Tlbowman42/F24_Team7_Lochinvar-Fan-Controller/README.md

# Lochinvar Fan Controller
## Executive Summary

The Fan Diagnostic Tool is a compact, modular system designed to test, simulate, and monitor blower fans used in boiler control systems. It streamlines diagnostics by offering multiple modes for real-time monitoring, fan simulation, and signal simulation. By improving testing speed and accuracy, the tool helps reduce development time, and enhance product reliability.

## Capabilities

The current version of our Fan Diagnostic Tool has the following capabilities:

1. Simulate a boiler fan
2. Generate PWM and Tachometer signals that can replicate boiler fans
3. Save user-parameters and load back the lastest saved data.

## Salient Outcomes

As the project progresses these are the outcomes we thought were more impressive than others. Listed below are our salient outcomes for this project:

1. Generate any Lochinvar designated fan signal.
2. Load and save user parameters.
3. Interface both with a function generator and the Lochinvar Control Board.

## Project Demonstration & Images
Photo of the final version of the tool, a video of the tool in Fam Simulation Mode, and a photo of the Lochinvar Control Board.





**Video of the Fan Diagnostic Tool running in Fan Simulation Mode**
https://youtube.com/shorts/UyiWjI823Lc?feature=share

## About Us

### Team

[Layne Bowman](https://www.linkedin.com/in/laynebowman/), an electrical engineering major at Tennessee Technological University, has a strong interest in power systems and renewable energy technologies. Layne oversees the power management systems for the fan diagnostic tool.  

[Ethan Haynes](https://www.linkedin.com/in/ethan-haynes-306a162b0/), an electrical engineering major at Tennessee Technological University, has a strong interest in power systems and renewable energy technologies. Ethan oversees the pre-processing subsystem for the fan diagnostic tool.    

[Jacob Brewer](https://www.linkedin.com/in/jacob-brewer-6b72a1254/) an electrical engineering major at Tennessee Tech University, has an strong interest in power distribution and renewable energy. Jacob oversees the production of the case with Ethan and the post-processing subsystem.  

[Tucker Basham](www.linkedin.com/in/tucker-basham-b77896290) as a computer engineer at Tennessee Tech University, has a strong passion for embedded, control systems, and signal processing. Tucker oversees the signal generation and storage capabilities of the fan diagnostic tool.  

[Conner Vick](https://www.linkedin.com/in/matthew-c-vick/) , an electrical engineering major at Tennessee Technological University, has a strong interest in design. Conner oversees the display for the fan diagnostic tool.  

### Faculty Supervisor

The faculty superviosr for this project is [Dr. JW Bruce](https://www.linkedin.com/in/jw-bruce-0b434326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). He completed his electrical engineering Bachelor's degree from The University of Alabama in Huntsville. He then went on and completed his Masters in electrical engineering at the Georgia Institue of Technology and his PhD in electrical engineering from the University of Nevada-Las Vegas.

### Stakeholders

The primary customer for the project is Lochinvar, which is a apart of the AO-Smith Corporation. There are plans for future capstone teams to develop both the Fan Driving mode and the Signal Passthrough mode.

### Recognitions

We would like to recognize and thank Dr. JW Bruce, Micah Rentschler, and our contacts at Lochinvar for their support and guidance throughout this project.  

## Repo Organization

### [Reports](https://github.com/Tlbowman42/F24_Team7_Lochinvar-Fan-Controller/tree/main/Reports)

The [Project Proposal](https://github.com/Tlbowman42/F24_Team7_Lochinvar-Fan-Controller/blob/main/Reports/Project%20Proposal.md) is the intial document for the project where the problem is defined and the goals for the project.  

The [Conceptual Design](https://github.com/Tlbowman42/F24_Team7_Lochinvar-Fan-Controller/blob/main/Reports/Conceptual%20Design%20and%20Planning.md) gives a more detailed solution to the problem as well as breakdowns the subsystems and gives a projected timeline and budget.  

The [Experimental Analysis](https://github.com/Tlbowman42/F24_Team7_Lochinvar-Fan-Controller/blob/main/Reports/Experimental%20Analysis.md) is where we designed and tested our Fan Diagnostic Tool to see if we met our success criteria set out in the Conceptual Design. 

The [Poster](https://github.com/Tlbowman42/F24_Team7_Lochinvar-Fan-Controller/blob/main/Reports/Capstone_Poster.pdf) is where we showcase our final project to advisors, faculty, and the public.

The [Final Presentation](https://github.com/Tlbowman42/F24_Team7_Lochinvar-Fan-Controller/blob/main/Reports/Final%20Capstone%20Presentation.pptx) is where we showcase our time in Capstone to the Industrial Advisory Board.

### [Documentation](https://github.com/Tlbowman42/F24_Team7_Lochinvar-Fan-Controller/tree/main/Documentation)

All documentation for the project is included in the above folder. Documentation includes all schematics, images, models, BOM, and designs used in the project.

The [Meeting Minutes](https://github.com/Tlbowman42/F24_Team7_Lochinvar-Fan-Controller/tree/main/Documentation/Meeting%20Minutes) folder contains the dated minutes from weekly meetings and allows a quick view into the progress of the team.

### [Software](https://github.com/Tlbowman42/F24_Team7_Lochinvar-Fan-Controller/tree/main/Software)

All software used and created is listed in the [Software](https://github.com/Tlbowman42/F24_Team7_Lochinvar-Fan-Controller/tree/main/Software) directory. For each subsystem, there are specific folders listed to find the necessary code.
