Tlbowman42/F24_Team7_Lochinvar-Fan-Controller/Reports/Jacob - Case & Post-Processing.md

# Function of the Subsystem  
The role of the post-processing subsystem is to step up the incoming Tach and PWM signals coming from the microcontroller. This subsystem will be responsible for electrically isolating the two different voltage levels using light to transfer the signal to the other circuit from the micro controller via an opto-coupler. It also will step up the signals to the necessary 10-12V and 24V DC. Then for the case the function is the protect and enclose the PCB and other components.

# Specifications and Constraints  
*Specifications*  
1. The Post-processing shall step up the tachometer and PWM signal, coming from the microcontroller, to send to the boiler controller.  
2. The Post-processing shall isolate the signal from backfeed.  
3. The case shall encase and protect the board.
4. The case shall have openings for the display, buttons, and ports.
5. The case shall have mounting points to secure the board.
6. The case shall include a raised bezel for the display for protection.  

*Constraints*  
1. The Post-processing must step up the PWM signal up from 3.3V to 24V.
2. The Post-processing must step up the Tach signal up from 3.3V to 10-12V
3. The case must fully protect all components inside of it.  
4. The subsystems must meet IPC J-STD-001.  

*Justifictation for Constraints*  
1. Constraint one applies because it is possible for the amplitude of the signals to be a range of values, but the pwm should be 24V and the tach will be 10V to 12V for accurate measurments.  
2. Constraint two applies because the case is useless if it doesn't provide adequate protection.  
3. Constraint three requires that proper soldering procedures, training, equipment, and materials are used. Following such guidelines will ensure safety and stable connections for the user of the tool and those working on it.

# Overview of Proposed Solution  
The post-processing system starts off with a tachometer and PWM signal (3.3V) that it steps up from the microcontroller to send to the boiler controller 10-12V for the tach signal or 24V for the pwm. It will also have a voltage regulator for the tach signal along with its supporting components. In addition to this, the signal must be isolated to protect the system from power surges. To accomplish this, an opto-coupler circuit will be implemented to meet both of these requirements. This circuit will consist of an opto-coupler, a current limiting resistor, and a pull up resistor. The case will be designed in solidworks then 3D printed.  

# Interfacing with Other Subsystems
Pre-Processing  
-The post-processing and case doesn't have any connection with the pre-processing sub system.  
Memory  
-The post-processing and the case doesn't have any connection with the memory sub system.
Microcontroller   
-The microcontroller subsystem will send a tachometer and PWM signal that has gone through the post-processing circuit.  
Display  
-The Display subsystem will display the interpreted version of the tachometer signal from the microcontroller.  
Case  
-The Case will account for the openings needed for the Molex connector and buttons.  
Power  
-The power system pulls up from the 24 V that went through the polarity checker.  
Display  
-The case will have an opening for the display.  
Ports and Buttons  
-The case will also have openings for all of the buttons and two openings for both of the molex connectors.  

# 3D design for case
Lid  
Screenshot (190)

Inside  
Screenshot (192)

# Buildable Schematic
Screenshot (204)  

Screenshot (205)  

# PCB
Screenshot (206)  

# BOM
| Manufacturer | Manufacturer Part Number | Distributor | Distributor Part Number | Quantity | Cost  | URL  | Lt Spice Name| Device Designations Kicad |
| :---: | :---: | :---: | :---: | :---: | :---: | :---: | :---: | :---: |
| Texas Instruments | LM317HVT/NOPB | Digikey |LM317HVT/NOPB-ND | 1 | $2.44| https://www.digikey.com/en/products/detail/texas-instruments/LM317HVT-NOPB/212662 | U1| U7 |
| KEMET | C333C104F5G5TA | Digikey |C333C104F5G5TA-ND | 1 | $6.10| https://www.digikey.com/en/products/detail/kemet/C333C104F5G5TA/6658919 | C1| C4 |
| Nichicon| UKL2A010KDD | Digikey |493-15407-ND | 1 | $0.43| https://www.digikey.com/en/products/detail/nichicon/UKL2A010KDD/2598552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 | C2| C5 |
| TE Connectivity Passive Product| LR1F240R| Digikey |A121513CT-ND | 1 | $0.10| https://www.digikey.com/en/products/detail/te-connectivity-passive-product/LR1F240R/2381208 | R1| R2d |
| Vishay Beyschlag/Draloric/BC Components | MRS25000C1651FCT00 | Digikey |56-MRS25000C1651FCT00CT-ND | 1 | $0.38| https://www.digikey.com/en/products/detail/vishay-beyschlag-draloric-bc-components/MRS25000C1651FCT00/5064119| R2| R21 |
| Vishay Dale | CMF5530R000FHEB | Digikey |541-CMF5530R000FHEBTR-ND | 1 | $0.80|https://www.digikey.com/en/products/detail/vishay-dale/CMF5530R000FHEB/3618953 | X | R22 |
| Stackpole Electronics Inc | RSMF1JT2K00 | Digikey |RSMF1JT2K00TR-ND | 2 | $0.40| https://www.digikey.com/en/products/detail/stackpole-electronics-inc/RSMF1JT2K00/1694491 | R3 and R4| R14 and R15 |
| Sharp Microelectronics | PC817X1YSZW | Mouser |852-PC817X1YSZW | 2 | $1.28| https://www.mouser.com/ProductDetail/Sharp-Microelectronics/PC817X1YSZW?qs=t7xnP681wgVcLhY5Ec%252BPYQ%3D%3D | U3 and U4| U5 and U6 |
| YAGEO | MFR-25FRF52-210R | Digikey |13-MFR-25FRF52-210RTR-ND | 2 | $0.20|https://www.digikey.com/en/products/detail/yageo/MFR-25FRF52-210R/14826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 | R1 and R2| R16 and R17 |
| ANYCUBIC | PLA filament | Amazon |PLA filament| 2 | $11.99|https://www.amazon.com/ANYCUBIC-Printer-Filament-Dimensional-Accuracy/dp/B0834W2MQN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 | Case| Case |
| Total | | | | | $ 24.12|  |  |

# Analysis
This document presents an analysis of the post-processing and case subsystem. The post-processing section is designed to receive PWM and TACH signals as inputs from the microcontroller. These signals are then stepped up to the appropriate voltage levels. Specifically, the PWM signal is increased from 3.3V to 24V, while the TACH signal is elevated from 3.3V to a range of 10-12V. The PWM circuit outputs a current of 10mA, and the TACH circuit outputs 5mA.  

The circuit begins with the PWM and TACH signal currents flowing through a 210 Ohm resistor. This configuration ensures that the forward current passing through the opto-coupler's LED remains within the desired range, thereby enhancing the longevity of the component and providing an accurate signal for processing. The selected opto-coupler, a PC817A, is well-suited for the 6 kHz PWM signal that needs to be processed. It can handle a maximum voltage of up to 40 Vdc, as specified in the datasheet, and has a cutoff frequency of 80 kHz with rise and fall times of up to 18 µs. These specifications allow the component to process the 6 kHz frequency signal without introducing significant distortion or delay. The 210 Ohm resistor value was determined using the formula ((V1-Vf)/i), calculated as ((3.3V - 1.2V)/10ma). On the output side of the opto-coupler for the PWM signal, a 2k Ohm resistor is employed. This resistor was originally 1.2k Ohms, but testing revealed that a 2k Ohm resistor produced a better output signal.  

The TACH signal required a more complex approach because it needed to be stepped up specifically to 10V, as requested by Lochinvar. Similar to the PWM signal, a 2k Ohm step-up resistor was used to improve the signal quality. However, in this case, a 10V to 40V linear converter was added to achieve the desired TACH output range of 10-12V.  

Tach
Screenshot (207)  

PWM
Screenshot (202)  

These picture shows the PWM and TACH out signals. The PWM shows the 24V output and the TACH shows the how the linear converter needs about 15ms to hit peak output voltage. Then the current going to the opto-coupler will be the same for both. Also you can see in the TACH ouput that it ramps up over time due to the linear converter.

PWM
Screenshot (199)

Screenshot (196)  

TACH
Screenshot (208)  
Screenshot (209)  

Then for the case it is pretty simple. The box/internal design shows the two holes needed for the controller and fan molex connectors. As well I rounded the corners on the inside of the case to allow room to be able screw the lid to the top of the box. Then the 4 pegs is where the flyback converter will be mounted and secured. Finally for the lid of the case we just have an opening for the LCD display and holes for all of the buttons. Although the case is subject to change due to the PCB layout being updated and improved through Bruce's guidance.

# References
[1] IEC 61010-2-081 - safety requirements for electrical equipment for measurement, control, and laboratory use – part 2-081: Particular requirements for automatic and semi-automatic laboratory equipment for analysis and other purposes | Engineering360,” GlobalSpec, https://standards.globalspec.com/std/13207536/IEC%2061010-2-081 (accessed Nov 22, 2024).

[2] "PC817X1YSZW" Sharp Electronics, https://www.mouser.com/datasheet/2/365/Sharpelectronics_08292023_73758-3310502.pdf (accessed Nov. 22, 2024).

[3] "https://www.digikey.com/en/products/detail/analog-devices-inc/LTC3115EDHD-1-PBF/3074265"

[4] "https://www.analog.com/media/en/technical-documentation/data-sheets/LTC3115-1.pdf"
