Tlbowman42/F24_Team7_Lochinvar-Fan-Controller/Questions for Abbey.md

Place any questions you will have for Abbey here.
1. Can you provide anymore information for the signals for our device, such as PWM input, tachometer output, and could you provide examples of the PWM and tachometer signals?
2. On the provided block diagram what does Circuitry / Isolation mean? In what way is the circuitry isolated?
3. In the fan driving mode, what voltage does the blower run off of? (Single-Phase 120 V?)
4. For the monitoring mode how many data points do our graphs need to be comprised of? (This will determine how complex our microcontroller needs to be for the software pass through mode.)

Come up with some crazy senarios, all of the ways it can go wrong and then go back to Abbey to get some more information. (These are big pictures then go into the more detail stuff) Throw the block diagram on the screen and just come up with what if scenario.  

Write a list of requirements that the tool needs to be and send it over to Abbey. Requirements are the big picture and using the basic knowledge and turning that basic knowledge into techincal details.  

Go back to Bruce and see if he will loosen his requirements for a working prototype.
