Tlbowman42/F24_Team7_Lochinvar-Fan-Controller/Documentation/Meeting Minutes/Minutes - 2025-03-26.md

# Wednesday, March 26th, 2025

## Attendance
**In Person** on 03/26/2025
1. Ethan Haynes
2. Layne Bowman
3. Tucker Basham
4. Jacob Brewer
5. Conner Vick

## Key Points
1. Worked on Experimental Analysis

2. Overall bug fixing

## Action Items for Past Meeting
1. We started Experimental Analysis and are closed to having a version to be peer reviewed.  

## Member Updates

Tucker Basham finished with testing the signal inputting and tach generation.  
Ethan Haynes found new 6 pin opto-couplers and helped test subsystems.  
Jacob Brewer picked up new board and button models.  
Conner Vick fixed bugs with LCD and was present for Experimental Analysis testing.  
Layne Bowman finished the Experimental Analysis testing both the power and memory subsystems.   

## Meeting Minutes
We started Experimental Analysis. We finished up most of our testing and need to document everything and submit it for peer review. We also found a new issue with the board that we are unsure of the causation. We are unsure on if it is a power or grounding issue, and we have tested multiple potential solutions with only one fixing the issue. We plan to look into that issue further this week and determine if it is a design issue or if we have damaged something.  

## Action Items for Next Meeting
To do list for the team:  
1. Turn in Experimental Analysis.

2. Work on PCB design and determine if another board would be possible to fix the issues we have come across.  

Ethan Haynes will work on a new board revision with Layne and continue testing with the board.  
Layne Bowman will look into issue on the board. Unsure if it is a power issue or a grounding issue.  
Tucker Basham will continue to work on the fan simulation mode and get better interface with the Lochinvar control board.  
Jacob Brewer will continue to work on the buttons. Then will help where needed.  
Conner Vick will help where needed.
