Tlbowman42/F24_Team7_Lochinvar-Fan-Controller/Documentation/Meeting Minutes/Minutes - 2024-10-23.md

# Wednesday, October 23th, 2024

## Attendance
**In Person:** on 10/23/2024
1. Ethan Haynes
2. Jacob Brewer
3. Conner Vick
4. Layne Bowman
5. Tucker Basham

**In Person** on 10/24/2024
1. Ethan Haynes
2. Jacob Brewer
3. Conner Vick
4. Layne Bowman
5. Tucker Basham

## Key Points
1. Explaining what we learned from our Lochinvar monthly meeting.

2. We went over what components we are looking at for each subsystem.
   
## Action Items for Past Meeting
1. We turned in our conceptual design for review.
  
2. We came up with outlier cases.

## Member Updates
Tucker Basham has found a possible microchip for the tool and has begun looking into code.  
Ethan Haynes has been learning KiCad and PCB design.  
Jacob Brewer looked into using solidworks software for the design of the case.  
Conner Vick has looked into the specifics behind selecting a display.  
Layne Bowman looked into different power ICs and also figured out how to do circuit analysis in Kicad, and designed a basic PCB.  

## Meeting Minutes
The team met with Lochinvar and they answered our questions. They also are going to send us some blower fans and the old fan diagnostic tool. We additionally explained the meeting to Dr Bruce and what new items we learned. Some examples of that information would be we do not have to provide the 120 V single phase power to drive the fan, the electrical isolation is specfically using opto-isolator, and we do not need to have graphs on our user interface. We also as a team explained the specific components we are planning on using.  

Tucker Basham has found a possible microchip for the tool and has begun looking into code.  
Ethan Haynes has been learning KiCad and PCB design.  
Jacob Brewer looked into using solidworks software for the design of the case.  
Conner Vick has looked into the specifics behind selecting a display.  
Layne Bowman looked into different power ICs and also figured out how to do circuit analysis in Kicad, and designed a basic PCB.  

## Action Items for Next Meeting
To do list for the team:  
1. Storyboard the design.
2. Finishing up selecting components for our design.

Ethan Haynes will watch KiCad tutorials.  
Layne Bowman will look into opto-isolators to isolate our power circuit from the microcontroller.  
Tucker Basham will look into procuring an STM32L452 chip or Nucleo-L452 board.  
Jacob Brewer look into how to download solidworks for free.  
Conner Vick will get menu design more finalized for team review.
