Tlbowman42/F24_Team7_Lochinvar-Fan-Controller/Gantt Chart.pdf

Team 7 | Legend:
Project start date: | 8/29/2024 | September | October
Scrolling increment: | 14 | 12 13 14 15 16 17 18 | 19 20 21 22 23 24 25 | 26 27 28 29 30 | 1 | 2 | 3 | 4 | 5 | 6 | 7 | 8 | 9 | 10 11 12 13 14 15 | 16 | 17 18 19 20 21 22 23 | 24 25 26 27 28 29 30 | 31 | 1 | 2 | 3 | 4 | 5 | 6 | 7 | 8 | 9 | 10 | 11 | 12 | 13 | 14 | 15 | 16
Milestone description | Category | Progress | Start | Days | T | F | S | S | M | T | W | T | F | S | S | M | T | W | T | F | S | S | M | T | W | T | F | S | S | M | T | W | T | F | S | S | M | T | W | T | F | S | S | M | T | W | T | F | S | S | M | T | W | T | F | S | S | M | T | W | T | F | S | S | M | T | W | T | F | S
Project Proposal | On Track | 9/12/2024 | 18
Preliminary Research | Low Risk | 9/25/2024 | 14
Conceptual Design Drafting | On Track | 10/9/2024 | 8
Fall Break | On Track | 10/17/2024 | 2
Conceptual Design Finalize | Low Risk | 10/18/2024 | 10
Subsystem Interfacing | Med Risk | 10/21/2024 | 14
Circuit Design | High Risk | 10/21/2024 | 21
PCB Design | 11/10/2024 | 21
Detailed Design | On Track | 10/28/2024 | 34
Final Presentation | Low Risk | 11/17/2024 | 14
Winter Break | On Track | 12/12/2024 | 35
Ordering | On Track | 1/16/2025 | 14
PCB Assembly | Low Risk | 1/26/2025 | 24

## Programming Microcontrollers

| On Track | 1/26/2025 | 30
Experimentation & analysis | Low Risk | 2/1/2025 | 28
Iteration and debug | On Track | 3/1/2025 | 60

## Final report and presentation

Low Risk | 4/1/2025 | 30

To add more data, Insert new rows ABOVE this one

High risk | Unassigned

# PROJECT: Lochinvar Fan Diagonostic Tool

On track | Low risk | Med risk

December | January | February
17 | 18 | 19 | 20 | 21 | 22 | 23 | 24 25 26 27 28 29 | 30 | 1 | 2 | 3 | 4 | 5 | 6 | 7 | 8 | 9 | 10 | 11 | 12 | 13 | 14 | 15 16 17 18 19 20 | 21 | 22 | 23 | 24 | 25 | 26 | 27 | 28 | 29 | 30 | 31 | 1 | 2 | 3 | 4 | 5 | 6 | 7 | 8 | 9 | 10 11 12 | 13 | 14 | 15 | 16 | 17 | 18 | 19 | 20 | 21 | 22 | 23 | 24 | 25 | 26 | 27 | 28 29 30 31 | 1 | 2 | 3 | 4 | 5 | 6 | 7 | 8 | 9 | 10 | 11 | 12 | 13 | 14 | 15
S | M | T | W | T | F | S | S | M | T | W | T | F | S | S | M | T | W | T | F | S | S | M | T | W | T | F | S | S | M | T | W | T | F | S | S | M | T | W | T | F | S | S | M | T | W | T | F | S | S | M | T | W | T | F | S | S | M | T | W | T | F | S | S | M | T | W | T | F | S | S | M | T | W | T | F | S | S | M | T | W | T | F | S | S | M | T | W | T | F | S

March | April | May
16 | 17 | 18 | 19 | 20 21 22 23 24 25 | 26 | 27 | 28 | 1 | 2 | 3 | 4 | 5 | 6 | 7 | 8 | 9 | 10 | 11 | 12 | 13 | 14 | 15 | 16 | 17 | 18 | 19 | 20 | 21 | 22 | 23 | 24 | 25 | 26 | 27 | 28 29 30 31 | 1 | 2 | 3 | 4 | 5 | 6 | 7 | 8 | 9 | 10 | 11 | 12 | 13 | 14 | 15 | 16 | 17 | 18 19 20 21 22 23 | 24 | 25 | 26 27 28 29 30 | 1 | 2 | 3 | 4 | 5 | 6 | 7 | 8 | 9 | 10 | 11 | 12 | 13 | 14 | 15 | 16 | 17
S | M | T | W | T | F | S | S | M | T | W | T | F | S | S | M | T | W | T | F | S | S | M | T | W | T | F | S | S | M | T | W | T | F | S | S | M | T | W | T | F | S | S | M | T | W | T | F | S | S | M | T | W | T | F | S | S | M | T | W | T | F | S | S | M | T | W | T | F | S | S | M | T | W | T | F | S | S | M | T | W | T | F | S | S | M | T | W | T | F | S

18 | 19 20 21 22 23 24 | 25 | 26 | 27 | 28 | 29 | 30 | 31 | 1 | 2
S | M | T | W | T | F | S | S | M | T | W | T | F | S | S | M
