Tlbowman42/F24_Team7_Lochinvar-Fan-Controller/Documentation/Meeting Minutes/Minutes - 2024-10-02.md

# Wednesday, October 2th, 2024

## Attendance
**In Person:** on 10/02/2024
1. Tucker Basham
2. Ethan Haynes
3. Jacob Brewer
4. Conner Vick
5. Layne Bowman

## Key Points
1. Getting Dr. Bruce's Github username, and sending him a review to approve of the project proposal.  

2. Created a draft block diagram to break up our problem into smaller subsections.  

3. Gave specific sections of the conceptual design to the team members.  

4. Assigned customers to each subsection.  

## Action Items for Past Meeting
1. Tucker sent Lochinvar our questions and we had a few of them answered.

2. Micah has approved the project proposal.

## Member Updates
Ethan Haynes finished the goals, Gantt Chart, and the goals for the project proposal.  
Tucker Basham finished the relevant literature for the project proposal.  
Layne Bowman finished the specifications and constraints and the goals for the project proposal.  
Jacob Brewer finished the broader impacts for the project proposal.  
Conner Vick finished the introduction section for the project proposal.  

## Meeting Minutes
The team met with Bruce and recapped the previous week with him. We also had him look over our project proposal, and we are in the process of sending him a pull request for him to digitally sign it. The team also broke down our project into subsections. The following subsections for each group member is displayed below.  

Tucker Basham has been assigned the back-end software design subsection.  
Ethan Haynes has been assigned the physical design subsection.  
Jacob Brewer has been assigned the circuitry subsection.  
Conner Vick has been assigned the front-end software design subsection.  
Layne Bowman has been assigned the power management subsection.  

The customers assignments are shown belowed:  

Tucker Basham is the customer for the circuitry subsection.  
Ethan Haynes is the customer for the power management subsection.  
Jacob Brewer is the customer for the front-end design subsection.  
Conner Vick is the customer for the back-end design subsection.  
Layne Bowman is the customer for the physical design subsection.  

The manager role will be assumed by the whole team instead of having individual managers.  

## Action Items for Next Meeting
To do list for the team:  
1. Then specify who will be doing the detailed design for that subsection.
2. Send Dr. Bruce the pull request for him to sign off on.
3. To come up with some crazy senarios for things to go wrong for our tool. The purpose of this is to find outliers, so we can base questions off on and get clarity from Abbey Ward.  

Tucker Basham: Will come up with specifications for the circuitry subsection.  
Ethan Haynes: Will come up with specifications for the power management subsection.  
Layne Bowman: Will come up with specifications for the physical design subsection.  
Jacob Brewer: Will come up with specifications for the front-end design subsection.  
Conner Vick: Will come up with specifications for the back-end design subsection.
