Tlbowman42/F24_Team7_Lochinvar-Fan-Controller/Documentation/Meeting Minutes/Lochinvar Meeting Minutes 10-23-2024.pdf

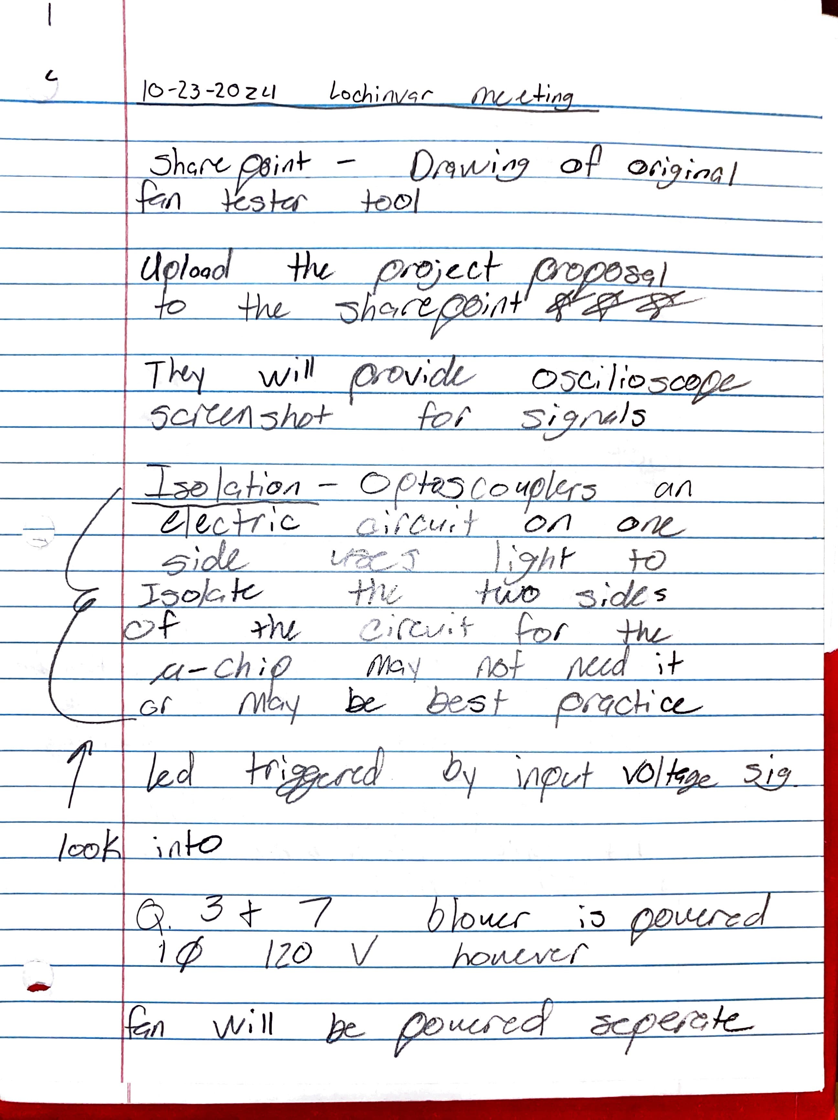
[picture p3: page 1]
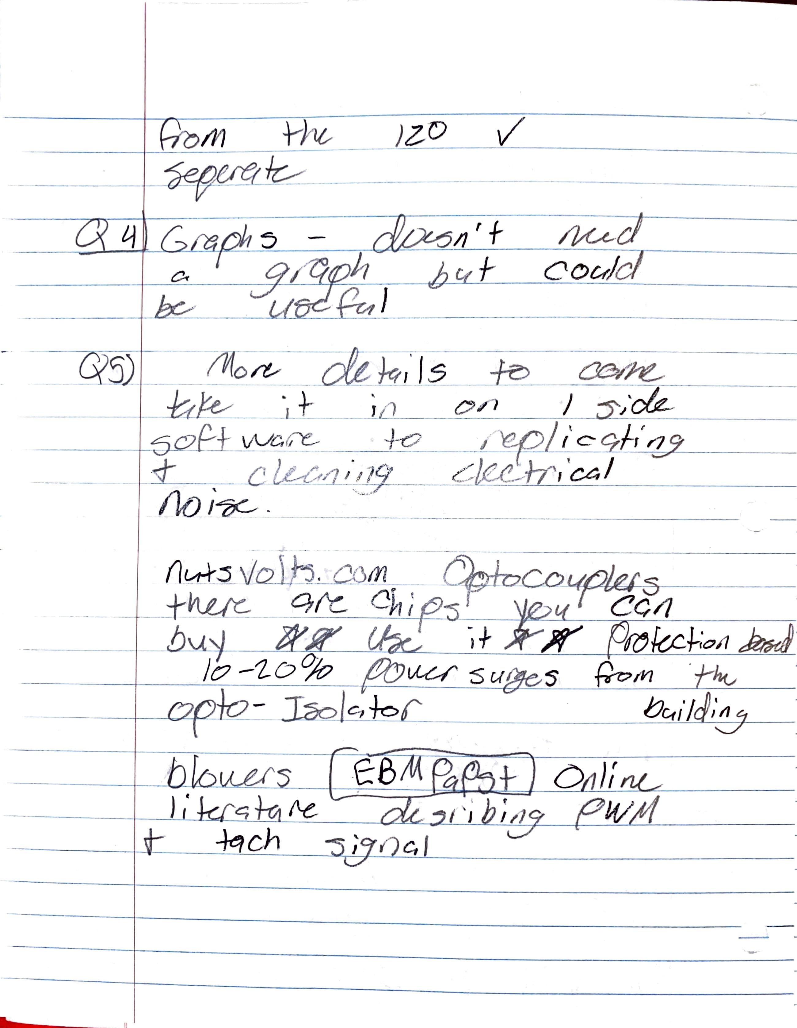
[picture p4: page 2]
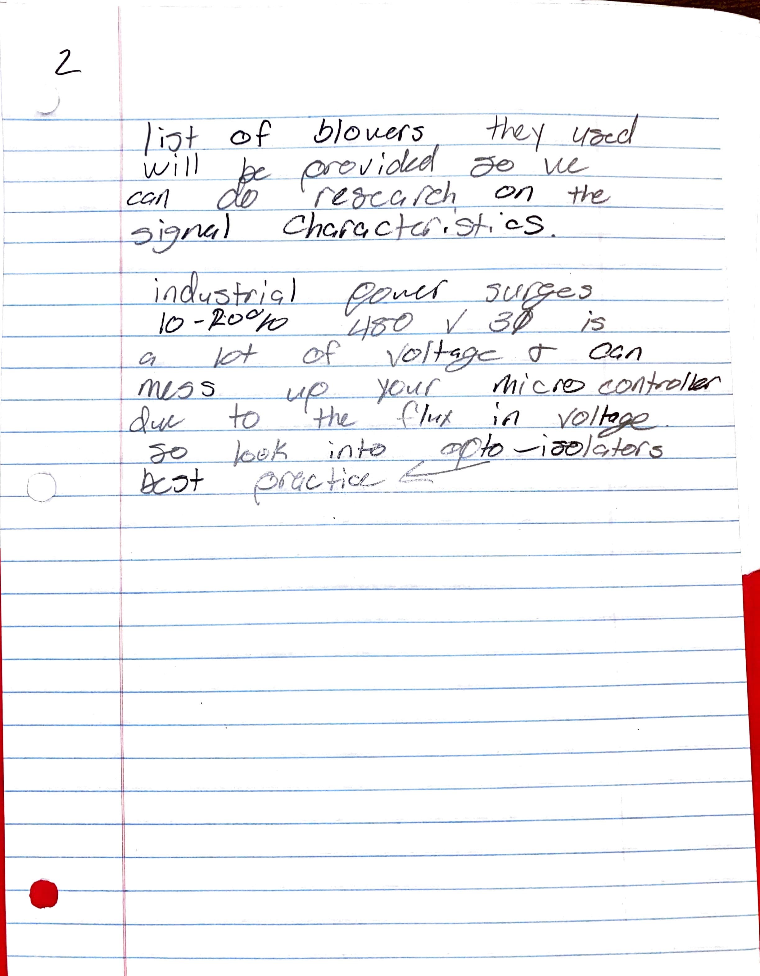
[picture p5: page 3]
