Tlbowman42/F24_Team7_Lochinvar-Fan-Controller/(list of files, cad)

Other CAD files:
Reports/Poster Template/Images/INN_Topology.dwg
