Tlbowman42/F24_Team7_Lochinvar-Fan-Controller/Testing.kicad_sch

## KiCad design Testing.kicad_sch (2025-01-27)

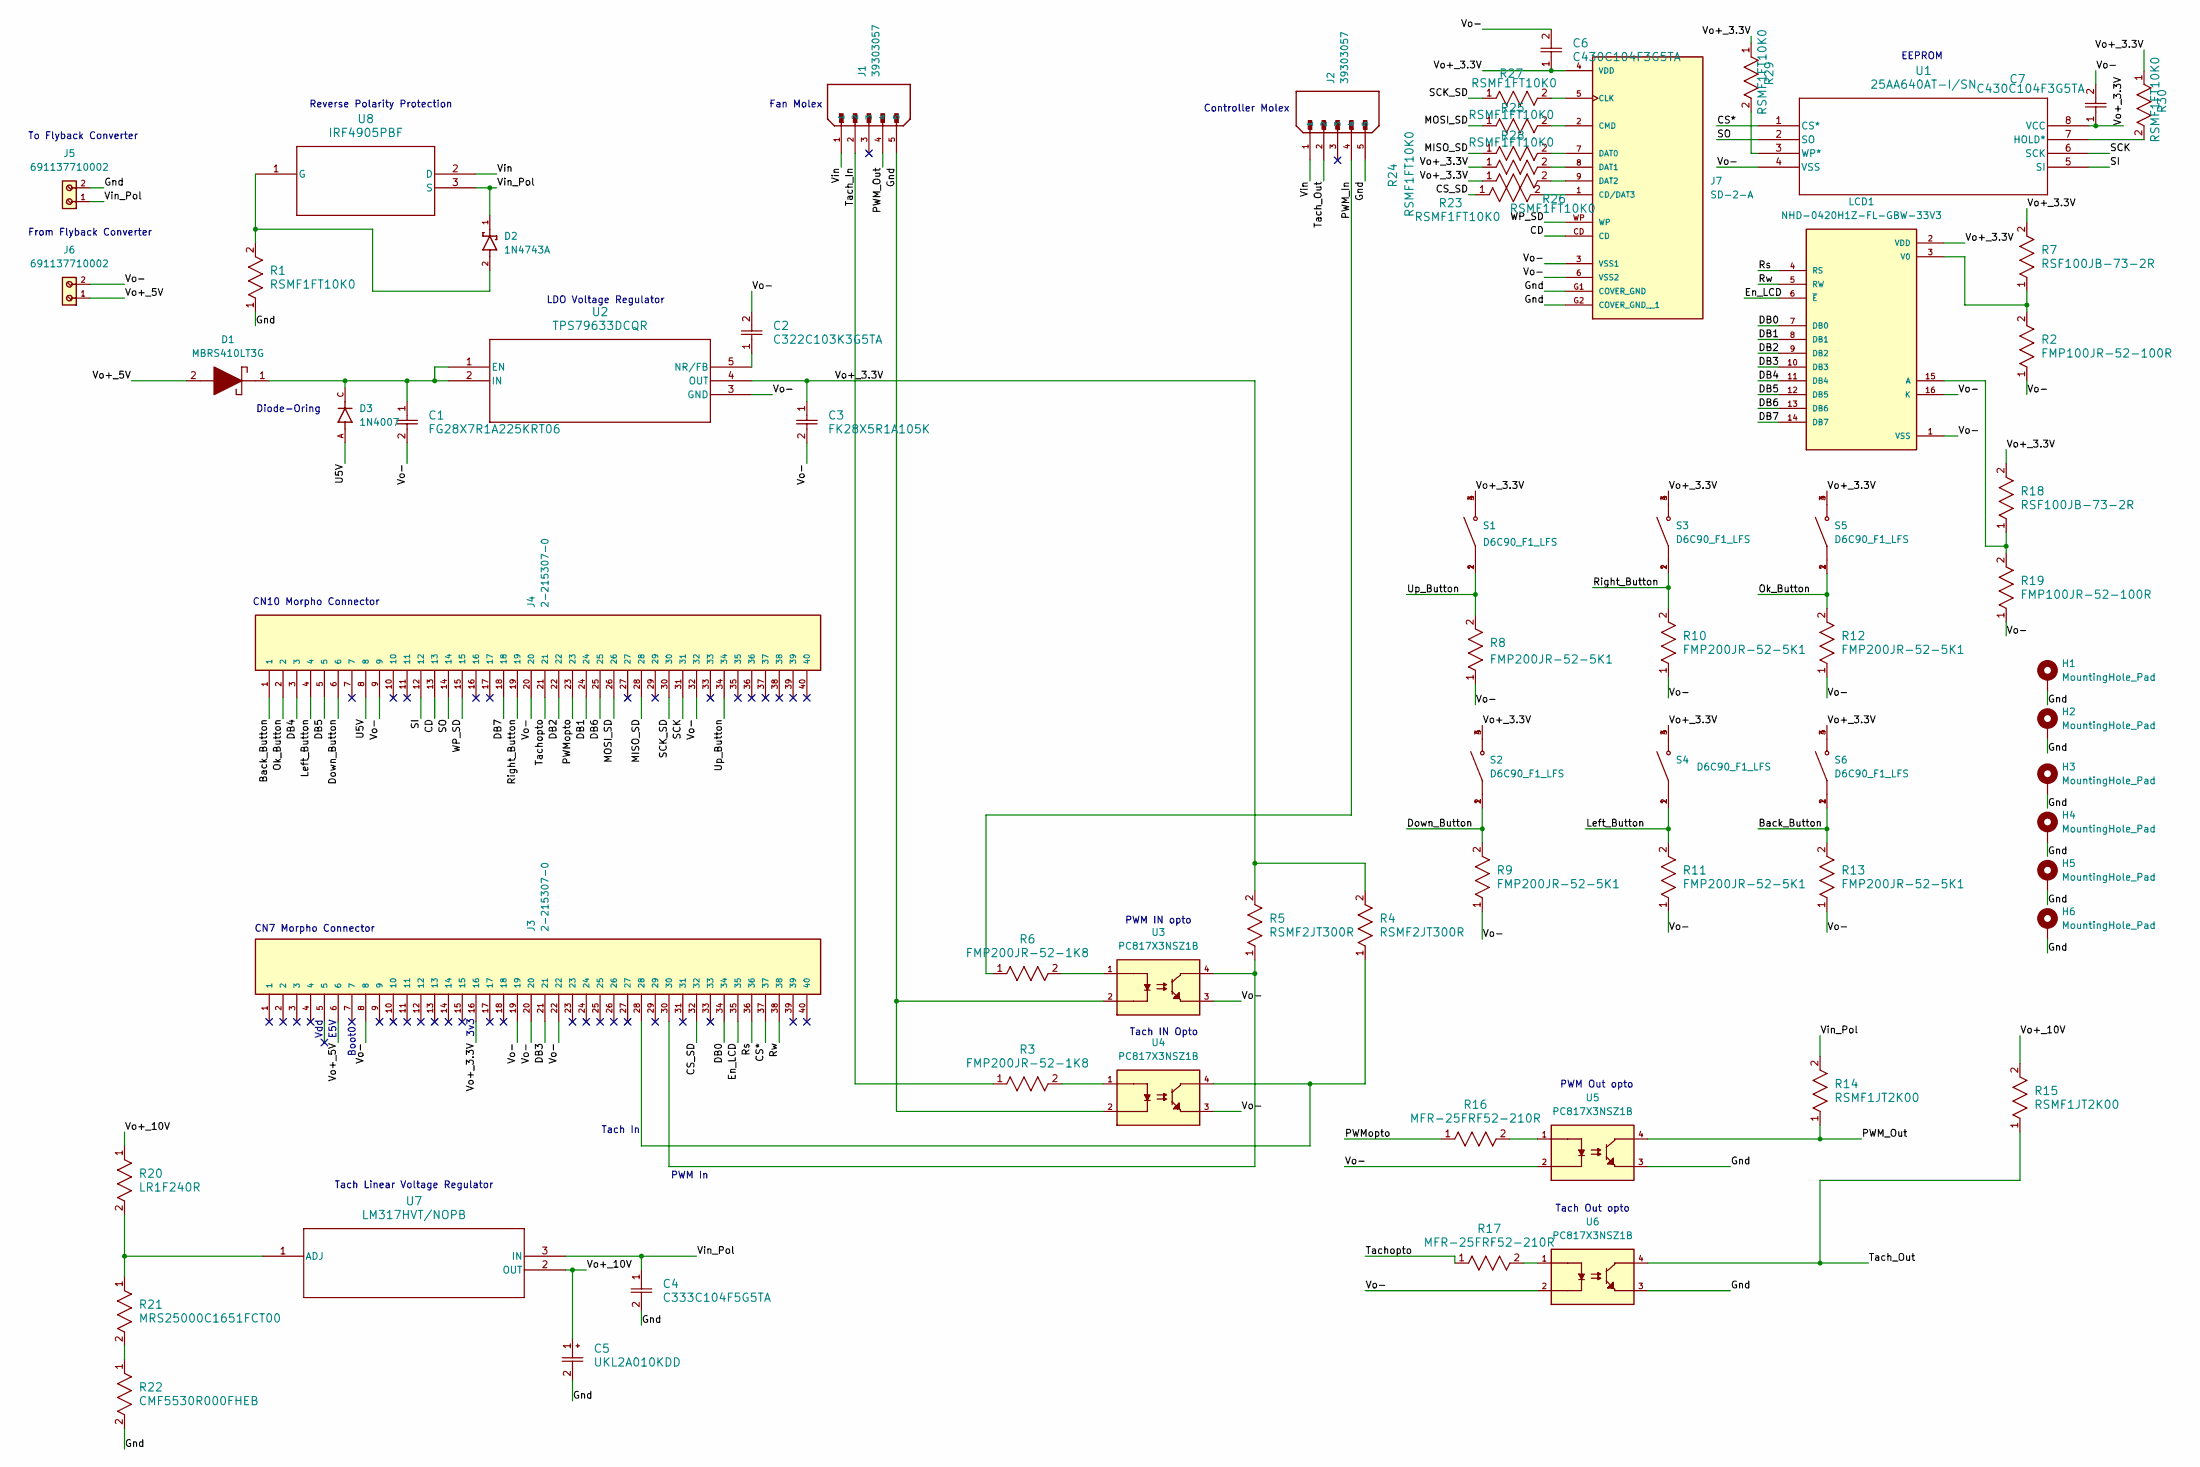
[picture p9: schematic Testing.kicad_sch]

Parts:
C1: FG28X7R1A225KRT06
C2: C322C103K3G5TA
C3: FK28X5R1A105K
C4: C333C104F5G5TA
C5: UKL2A010KDD
C6, C7: C430C104F3G5TA
D1: MBRS410LT3G; DIOM8059X261N; Manufacturer_Part_Number MBRS410LT3G; Mouser Part Number 863-MBRS410LT3G
D2: 1N4743A; DIOAD1036W78L463D272; PARTREV 10
D3: 1N4007; DIOAD1060W80L520D270; PARTREV G
H1, H2, H3, H4, H5, H6: MountingHole_Pad; MountingHole_5.3mm_M5_ISO7380_Pad_TopBottom
J1, J2: 39303057; MOLEX_39303057; PARTREV A
J3, J4: 2-215307-0; TE_2-215307-0; PARTREV R
J5, J6: 691137710002; PART-NUMBER 691137710002
J7: SD-2-A; SD_2_A; PARTREV 1.0
LCD1: NHD-0420H1Z-FL-GBW-33V3; LCD_NHD-0420H1Z-FL-GBW-33V3; PARTREV 02
R1: RSMF1FT10K0; FMP200JR_52_1K8
R2, R19: FMP100JR-52-100R; FMP100JR_52_100R
R3, R6: FMP200JR-52-1K8; FMP200JR_52_1K8
R4, R5: RSMF2JT300R; FMP200JR_52_1K8
R7, R18: RSF100JB-73-2R; RSF100JB_73_2R
R8, R9, R10, R11, R12, R13: FMP200JR-52-5K1; FMP200JR_52_5K1
R14, R15: RSMF1JT2K00; FMP100JR_52_100R
R16, R17: MFR-25FRF52-210R; MFR_25FRF52_210R
R20: LR1F240R
R21: MRS25000C1651FCT00
R22: CMF5530R000FHEB
R23, R24, R25, R26, R27, R28, R29, R30: RSMF1FT10K0; FMP100JR_52_1K2
S1, S2, S3, S4, S5, S6: D6C90_F1_LFS; SW_D6C90_F1_LFS; PARTREV 21 Feb 22
U1: 25AA640AT-I/SN; 25AA640AT_I_SN
U2: TPS79633DCQR
U3, U4, U5, U6: PC817X3NSZ1B; DIP762W50P254L495H455Q4; PARTREV October 7, 2016
U7: LM317HVT/NOPB; LM317HVT_NOPB
U8: IRF4905PBF

Connections:
Back_Button: J4.1, R13.2, S6.1, S6.2
CD: J4.13, J7.CD
CS*: J3.37, U1.1 (CS*)
CS_SD: J3.32, R26.1
DB0: J3.34, LCD1.7 (DB0)
DB1: J4.24, LCD1.8 (DB1)
DB2: J4.22, LCD1.9 (DB2)
DB3: J3.21, LCD1.10 (DB3)
DB4: J4.3, LCD1.11 (DB4)
DB5: J4.5, LCD1.12 (DB5)
DB6: J4.25, LCD1.13 (DB6)
DB7: J4.18, LCD1.14 (DB7)
Down_Button: J4.6, R9.2, S2.1, S2.2
En_LCD: J3.35, LCD1.6 (~E)
Gnd: C4.2, C5.2, H1.1, H2.1, H3.1, H4.1, H5.1, H6.1, J1.5, J2.5, J5.2, J7.G1 (COVER_GND), J7.G2 (COVER_GND__1), R1.1, R22.2, U3.2, U4.2, U5.3, U6.3
Left_Button: J4.4, R11.2, S4.1, S4.2
MISO_SD: J4.28, R28.1
MOSI_SD: J4.26, R25.1
unnamed: C1.1, D1.1, D3.C, U2.1 (EN), U2.2 (IN)
unnamed: C2.1, U2.5 (NR/FB)
unnamed: D2.2, R1.2, U8.1 (G)
unnamed: J3.28, R4.1, U4.4
unnamed: J3.30, R5.1, U3.4
unnamed: J7.1 (CD/DAT3), R26.2
unnamed: J7.2 (CMD), R25.2
unnamed: J7.5 (CLK), R27.2
unnamed: J7.7 (DAT0), R28.2
unnamed: J7.8 (DAT1), R23.2
unnamed: J7.9 (DAT2), R24.2
unnamed: LCD1.3 (V0), R2.2, R7.1
unnamed: LCD1.15 (A), R18.1, R19.2
unnamed: R3.2, U4.1
unnamed: R6.2, U3.1
unnamed: R16.2, U5.1
unnamed: R17.2, U6.1
unnamed: R20.2, R21.1, U7.1 (ADJ)
unnamed: R21.2, R22.1
unnamed: R29.2, U1.3 (WP*)
unnamed: R30.2, U1.7 (HOLD*)
Ok_Button: J4.2, R12.2, S5.1, S5.2
PWM_In: J2.4, R6.1
PWM_Out: J1.4, R14.1, U5.4
PWMopto: J4.23, R16.1
Right_Button: J4.19, R10.2, S3.1, S3.2
Rs: J3.36, LCD1.4 (RS)
Rw: J3.38, LCD1.5 (RW)
SCK: J4.31, U1.6 (SCK)
SCK_SD: J4.30, R27.1
SI: J4.12, U1.5 (SI)
SO: J4.14, U1.2 (SO)
Tach_In: J1.2, R3.1
Tach_Out: J2.2, R15.1, U6.4
Tachopto: J4.21, R17.1
U5V: D3.A, J4.8
Up_Button: J4.34, R8.2, S1.1, S1.2
Vin: J1.1, J2.1, U8.2 (D)
Vin_Pol: C4.1, D2.1, J5.1, R14.2, U7.3 (IN), U8.3 (S)
Vo+_3.3V: C3.1, C6.1, C7.1, J3.16, J7.4 (VDD), LCD1.2 (VDD), R4.2, R5.2, R7.2, R18.2, R23.1, R24.1, R29.1, R30.1, S1.3, S1.4, S2.3, S2.4, S3.3, S3.4, S4.3, S4.4, S5.3, S5.4, S6.3, S6.4, U1.8 (VCC), U2.4 (OUT)
Vo+_5V: D1.2, J3.6, J6.1
Vo+_10V: C5.1, R15.2, R20.1, U7.2 (OUT)
Vo-: C1.2, C2.2, C3.2, C6.2, C7.2, J3.8, J3.19, J3.20, J3.22, J4.9, J4.20, J4.32, J6.2, J7.3 (VSS1), J7.6 (VSS2), LCD1.1 (VSS), LCD1.16 (K), R2.1, R8.1, R9.1, R10.1, R11.1, R12.1, R13.1, R19.1, U1.4 (VSS), U2.3 (GND), U3.3, U4.3, U5.2, U6.2
WP_SD: J4.15, J7.WP

Notes on the sheet:
From Flyback Converter
PWM Out opto
LDO Voltage Regulator
Diode-Oring
Tach IN Opto
To Flyback Converter
Tach In
Fan Molex
Tach Out opto
CN10 Morpho Connector
PWM IN opto
Controller Molex
Tach Linear Voltage Regulator
Reverse Polarity Protection
PWM In
E5V
Vdd
CN7 Morpho Connector
Boot0
EEPROM
3v3
