Tlbowman42/F24_Team7_Lochinvar-Fan-Controller/(commit log)

2024-10-07 Update Conceptual Design and Planning.md
    power specification
2024-10-08 Update Conceptual Design and Planning.md
    Added first draft of introduction and Circuitry customer specifications.
2024-10-09 Update Conceptual Design and Planning.md
    Added the operational flow chart
2024-10-10 Update Conceptual Design and Planning.md
    Took away the four layer pcb specification.
2024-10-10 Update Conceptual Design and Planning.md
    Added in a description of the power and circuitry subsection.
2024-10-10 Update Conceptual Design and Planning.md
    Added more to the power/circuitry subsystem
2024-10-10 Update Conceptual Design and Planning.md
    Updated the operational flow chart
2024-10-11 Update Conceptual Design and Planning.md
    Additions and fixes to power/circuitry.
2024-10-11 Update Conceptual Design and Planning.md
    Added back my description of the power subsystem
2024-10-11 Update Conceptual Design and Planning.md
    Updated the specs and description for the Power subsytem
2024-10-11 Update Conceptual Design and Planning.md
    Updated the power description
2024-10-11 Update Conceptual Design and Planning.md
    Updated the power description.
2024-10-11 Update Conceptual Design and Planning.md
    PCB section
2024-10-11 Update Conceptual Design and Planning.md
    Added in possible solutions for the PCB
2024-10-11 Update Conceptual Design and Planning.md
    solutions for pcbs
2024-10-11 Update Conceptual Design and Planning.md
    Added more to the PCB solutions.
2024-10-11 Update Conceptual Design and Planning.md
    Finishing up the PCB solutions.
2024-10-12 Update Conceptual Design and Planning.md
    PCB design subsection addressing standards
2024-10-12 Update Conceptual Design and Planning.md
    Updated power solutions
2024-10-12 Update Conceptual Design and Planning.md
    Finished up the power solutions.
2024-10-12 Update Conceptual Design and Planning.md
    Case specifications
2024-10-12 Update Conceptual Design and Planning.md
    Updating case solutions.
2024-10-12 Update Conceptual Design and Planning.md
    Updated case solutions.
2024-10-12 Update Conceptual Design and Planning.md
    finished up the case possible solutions.
2024-10-14 Update Conceptual Design and Planning.md
    PCB subsection draft
2024-10-15 Update Conceptual Design and Planning.md
    PCB subsection
2024-10-15 Update Conceptual Design and Planning.md
    Added power/circuitry cost
2024-10-25 Update Conceptual Design and Planning.md
    Removed the PCB possible solutions
2024-10-26 Update Conceptual Design and Planning.md
    Added potential solutions for the connections and buttons subsystem
2024-10-26 Update Conceptual Design and Planning.md
    Updated the power subsystem interfacing and details. Also fixed a lot of misspelling errors
2024-10-26 Update Conceptual Design and Planning.md
    Changed the Connections and Buttons subsystem to Ports and Buttons
2024-10-26 Update Conceptual Design and Planning.md
    Updated the power subsystem specs
2024-10-26 Update Conceptual Design and Planning.md
    ports and buttons update
2024-10-27 Update Conceptual Design and Planning.md
    removed PCB from display interface description
2024-10-29 Create Layne - Power System Detailed Design.md
    Created a file for Layne Bowman to put the Power Subsystem's design in
2024-10-29 Create Jacob - Case & Post-Processing.md
    Created a file for Layne Bowman to put the Case & Post-Processing Subsystem's design in
2024-10-29 Create Ethan - Ports & Buttons & Pre-Processing Subs.md
    Created a file for Ethan Haynes to put the Ports & Buttons & Pre-Processing Subsystem's design in
2024-10-29 Rename Layne - Power System Detailed Design.md to Layne - Power Sub.md
2024-11-11 Update Layne - Power Sub.md
    Created the skeleton for my detailed design
2024-11-11 Update Layne - Power Sub.md
    Added in the Function of the Subsystem section
2024-11-12 Update Ethan - Ports & Buttons & Pre-Processing Subs.md
    Function
2024-11-12 Update Ethan - Ports & Buttons & Pre-Processing Subs.md
    Adding information on preprocessing
2024-11-19 Update Layne - Power Sub.md
    Adding onto everything.
2024-11-20 Update Layne - Power Sub.md
2024-11-20 Update Layne - Power Sub.md
    Updated the design therefore I have updated the BOM
2024-11-21 Update Layne - Power Sub.md
    Updated my BOM due to adding capacitors onto my LDO Voltage Regulator.
2024-11-21 Update Layne - Power Sub.md
    Added Schematic component names to the BOM
2024-11-21 Update Layne - Power Sub.md
    Added in my resistor
2024-11-21 Update Layne - Power Sub.md
    Added onto the analysis section
2024-11-21 Update Layne - Power Sub.md
    Updated formatting
2024-11-21 Update Layne - Power Sub.md
    Updating the analysis
2024-11-21 Update Layne - Power Sub.md
    Updated the analysis section
2024-11-21 Update Ethan - Ports & Buttons & Pre-Processing Subs.md
    Updated subsection
2024-11-21 Update Layne - Power Sub.md
    Updating the polarity circuit
2024-11-21 Update Layne - Power Sub.md
    Uploaded more spice diagrams
2024-11-21 Add files via upload
    Uploading the error logs for the Diode-Oring with LDO Voltage regulator circuit to show the graphs in a numerical way.
2024-11-21 Update Ethan - Ports & Buttons & Pre-Processing Subs.md
    updated bom
2024-11-21 Update Layne - Power Sub.md
    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
2024-11-21 Update Ethan - Ports & Buttons & Pre-Processing Subs.md
    urls
2024-11-21 Update Jacob - Case & Post-Processing.md
2024-11-21 Update Ethan - Ports & Buttons & Pre-Processing Subs.md
    updated photos
2024-11-22 Update Layne - Power Sub.md
    Finishing up the analysis
2024-11-22 Update Ethan - Ports & Buttons & Pre-Processing Subs.md
    bom
2024-11-22 Update Tucker - Microcontroller Sub.md
    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
2024-11-22 Update Ethan - Ports & Buttons & Pre-Processing Subs.md
    bom and analysis
2024-11-22 Update Ethan - Ports & Buttons & Pre-Processing Subs.md
    analysis
2024-11-22 Update Ethan - Ports & Buttons & Pre-Processing Subs.md
2024-11-23 Update Layne - Power Sub.md
    Added the PCB and 3d Viewer
2024-11-23 Add files via upload
    Adding the Gerber Job file and schematic
    [Testing.kicad_sch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]
2024-11-23 Update Layne - Power Sub.md
    Corrected the comments Ethan left me.
2024-11-23 Create Ethan Ports & Buttons Sub
2024-11-23 Rename Ethan - Ports & Buttons & Pre-Processing Subs.md to Ethan - Pre-Processing Subs.md
2024-11-23 Rename Ethan Ports & Buttons Sub to Ethan Ports & Buttons Sub.md
2024-11-23 Update Ethan Ports & Buttons Sub.md
2024-11-23 Update Layne - Power Sub.md
    Added the PCB to the BOM. I am unsure on if it needs to be on there.
2024-11-24 Update Layne - Power Sub.md
    Updated the total cost on the BOM.
2024-11-24 Update Tucker - Microcontroller Sub.md
    added flowchart
2024-11-24 Rename Ethan Ports & Buttons Sub.md to Ethan - Ports & Buttons Sub.md
2024-11-25 Update Tucker - Microcontroller Sub.md
    hot fix for flowchart
2024-11-25 Update Ethan - Ports & Buttons Sub.md
2024-11-25 Update Ethan - Ports & Buttons Sub.md
    Updated references
2024-11-25 Update Layne - Power Sub.md
    Updated the BOM
2024-11-27 Update Layne - Power Sub.md
    Updated spelling errors and grammar mistakes.
2024-11-27 Update Conner - Display Subs.md
    UPADATED BOM AND schematic pic
2024-11-30 Update Layne - Power Sub.md
    Updating the references list.
2024-11-30 Update Layne - Power Sub.md
    Added in information about max current draw.
2024-11-30 Update Layne - Power Sub.md
    Added in current and power dissipation limitations.
2024-11-30 Update Layne - Power Sub.md
    Fixing grammar and spelling
2024-12-01 Update Ethan - Ports & Buttons Sub.md
    fixed typos
2024-12-03 Update Layne - Power Sub.md
    Updated the BOM and PCB Schematic for the new Power MOSFET and heat sink.
2024-12-03 Update Layne - Power Sub.md
    Changed the analysis for the new power mosfet and added thermal management procedures for the LDO
2024-12-03 Update Layne - Power Sub.md
    Adding in thermal paste for the heat sink to the analysis and BOM
2024-12-04 Update Layne - Power Sub.md
    Adding the new Lochinvar Spec and changed the power dissipation and temperature calculation for the power mosfet.
2024-12-04 Update Ethan - Ports & Buttons Sub.md
    fixed references
2024-12-04 Add files via upload
    Adding an updated version of the schematic and gerber file.
    [Testing.kicad_sch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]
2024-12-05 Update Ethan - Ports & Buttons Sub.md
    FIxed BOM and references
2024-12-05 Update Ethan - Pre-Processing Sub.md
    Fixed BOM and references
2025-01-25 Update Layne - Power Sub.md
    Updated photos of the schematic, board file, and 3D viewer of the PCB
2025-01-25 Delete Reports/Testing-job.gbrjob
    Deleting the Gerber Job file to upload the new one.
    [Testing-job.gbrjob]
2025-01-25 Delete Reports/Testing.kicad_sch
    Deleting the schematic file to upload the new one
    [Testing.kicad_sch]
2025-01-25 Add files via upload
    Uploading the most up-to-date version of the Gerber Job file.
    [Testing-job.gbrjob]
2025-01-25 Add files via upload
    Uploading the most up-to-date version of the schematic file.
    [Testing.kicad_sch]
2025-03-30 Update Experimental Analysis.md
    Adding in a table for fan sim test
